libc0607/vision-c3-youth/PCB/README.md

# Vision C3 Youth PCB

PCB 厚度 1.2 mm  
如果不使用 TF 卡，C8, C9, R8 和卡座可不焊  
目前代码中没有做电池电压检测，R10 和 R17 可不焊  
UART 仅预留但不需要，H1 和 R11 不焊  
D2 预留给其他充电输入，用不到就不焊
