libc0607/vision-c3-youth/PCB/Schematic_Liyue_C3_Youth_v1_2022-06-08.pdf

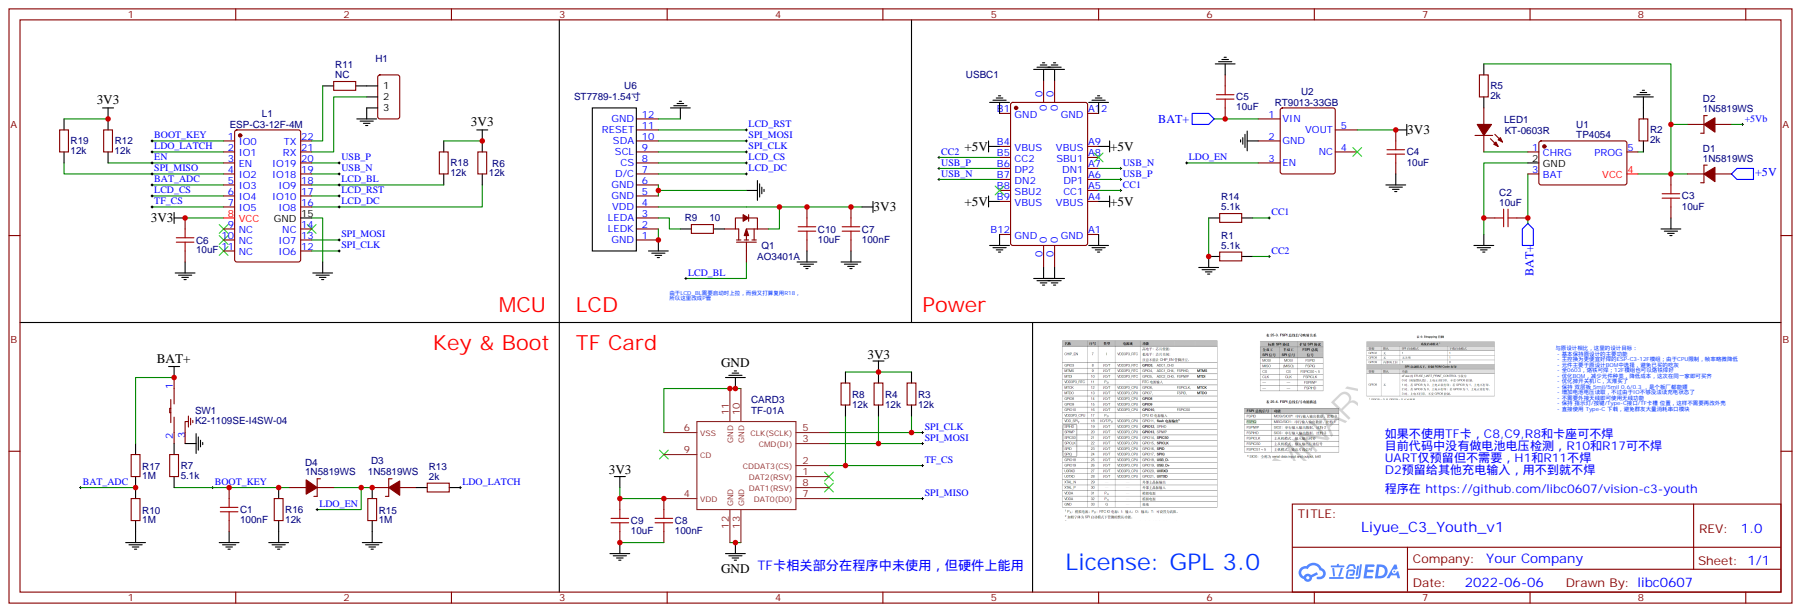
[picture p1: page 1]

与原设计相比，这里的设计目标：
- 基本保持原设计的主要功能
- 主控换为更便宜好焊的ESP-C3-12F模组；由于CPU限制，帧率略微降低
- 元件主要于原设计BOM中选择，避免已买的吃灰
- 全0603，烙铁可焊；12F模组也可以烙铁焊好
- 优化BOM，减少元件种类，降低成本，这次在同一家即可买齐
- 优化掉开关机IC，太难买了
- 保持 双层板 5mil/5mil 0.6/0.3 ，是个板厂都能嫖
- 增加电池电压读取，不过由于IO不够没法读充电状态了
- 不需要外接天线即可使用无线功能
- 保持 指示灯/按键/Type-C接口/TF卡槽 位置，这样不需要再改外壳
- 直接使用 Type-C 下载，避免群友大量消耗串口模块

GND 13 GND 10 GND 11 GND 12

如果不使用TF卡，C8,C9,R8和卡座可不焊
目前代码中没有做电池电压检测，R10和R17可不焊
UART仅预留但不需要，H1和R11不焊
D2预留给其他充电输入，用不到就不焊
程序在 https://github.com/libc0607/vision-c3-youth
